iwasz/gp8-clock/README

Stopwatch project for moto-gymkhana.
In case you don't know what is moto-gymkhana : https://www.youtube.com/watch?v=KFEh59GVMnQ
