iwasz/gp8-clock/hw-design/receiver/gp8-clock.ods

10 | D1 | weight-scale-backlight | 1 | LED | 0 | with LCD | 0 | 0 |  | 0
11 | U2 | MSOP10 | 1 | MCP73833 | 0 |  | 0 | 0 |  | 0
12 | SW1 | pin_socket_2 | 1 | power | 0 |  | 0 | 0 |  | 0
16 | P1 | pin_socket_3 | 1 | CONN_01X03 | 0 |  | 0 | 0 |  | 0
18 | P6 | pin_socket_2 | 1 | CONN_01X02 | 0 |  | 0 | 0 |  | 0
19 | P8 | pin_socket_2 | 1 | OptionB | 0 |  | 0 | 0 |  | 0
20 | P9 | pin_socket_2 | 1 | OptionA | 0 |  | 0 | 0 |  | 0
21 | P12 | pin_socket_2 | 1 | OptionC | 0 |  | 0 | 0 |  | 0
23 | R9 | 0207%2f10 | 1 | current sense 1R | 0 |  | 0 | 0 |  | 0
 | bateria 300mah |  | 1 |  | 12 |  | 12 | 0 | 2 lub 3x AA | 0
19 | R9 | r_0603 | 1 | 560R | 0.02 |  | 0.02 | 0.02 |  | 0.02
20 | R13 | r_0603 | 1 | 1R | 0.02 |  | 0.02 | 0.02 |  | 0.02
21 | R22 | r_0603 | 1 | 220R | 0.02 |  | 0.02 | 0.02 |  | 0.02
23 | R28 | r_0603 | 1 | 3k3 | 0.02 |  | 0.02 | 0.02 |  | 0.02
7 | R4 | r_0603 | 1 | 3k3 | 0.02 |  | 0.02 | 0.02 |  | 0.02
8 | R5 | r_0603 | 1 | 33k | 0.02 |  | 0.02 | 0.02 |  | 0.02
10 | R8 | r_1210 | 1 | 2R | 0.02 |  | 0.02 | 0.02 |  | 0.02
11 | C1 | c_0603 | 1 | C | 0.03 |  | 0.03 | 0.03 |  | 0.03
12 | C2 | c_0603 | 1 | 1µF | 0.03 |  | 0.03 | 0.03 |  | 0.03
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
