iwasz/gp8-clock/doc/lcd-dmiensions.jpg

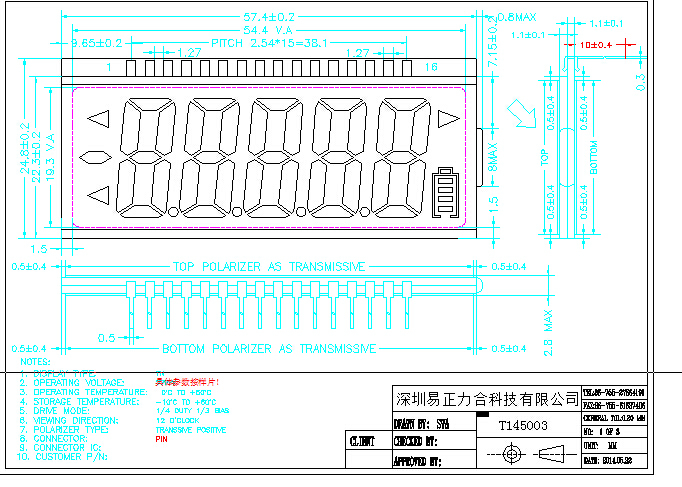
doc/lcd-dmiensions.jpg
