iwasz/gp8-clock/doc/lcd-pinout.jpg

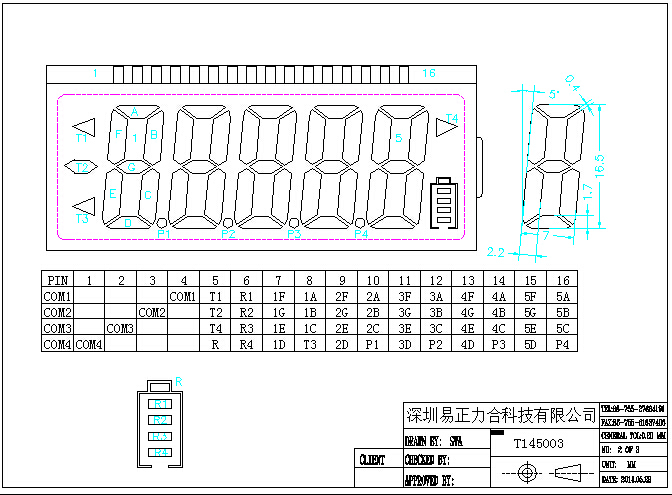
doc/lcd-pinout.jpg
