iwasz/gp8-clock/hw-design/receiver/board-outline/Screenshot from 2015-11-08 22:54:55.png

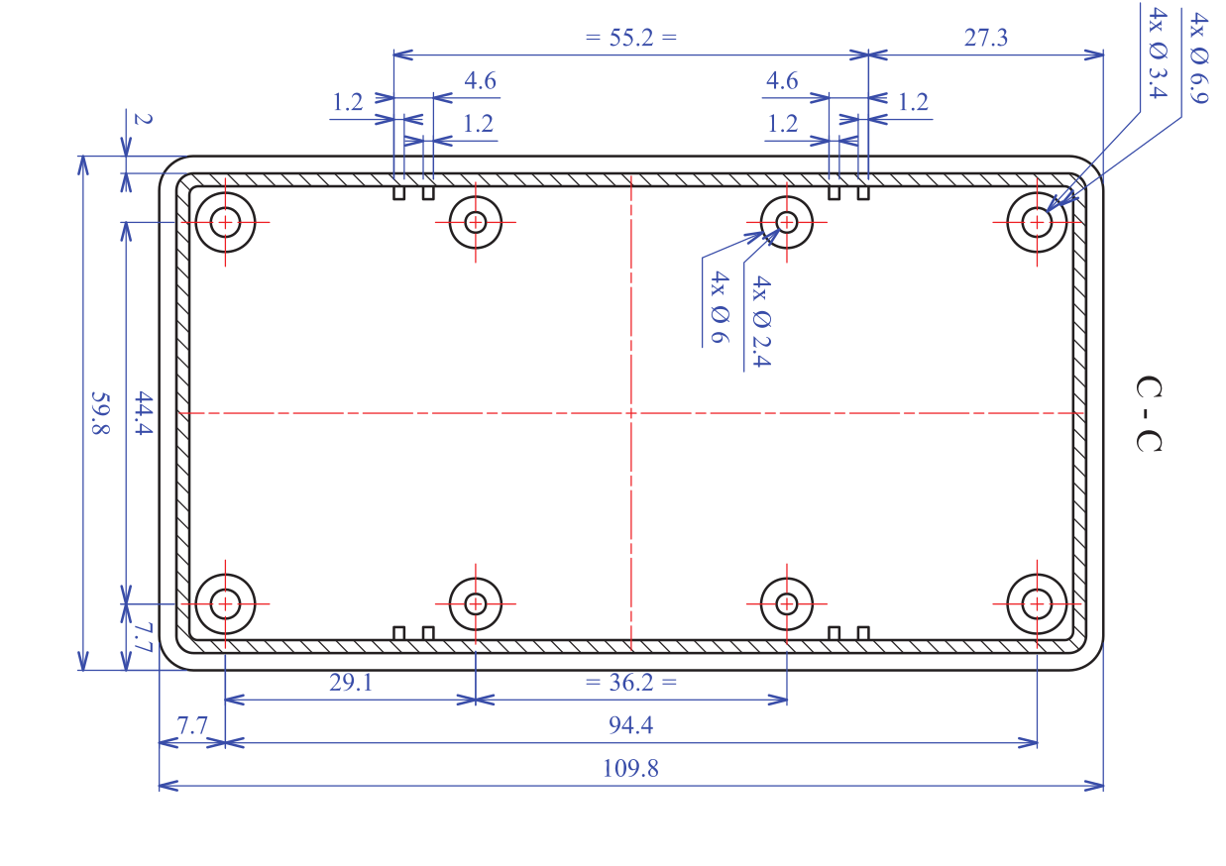
hw-design/receiver/board-outline/Screenshot from 2015-11-08 22:54:55.png
