iwasz/gp8-clock/hw-design/transmitter/board-outline/case.png

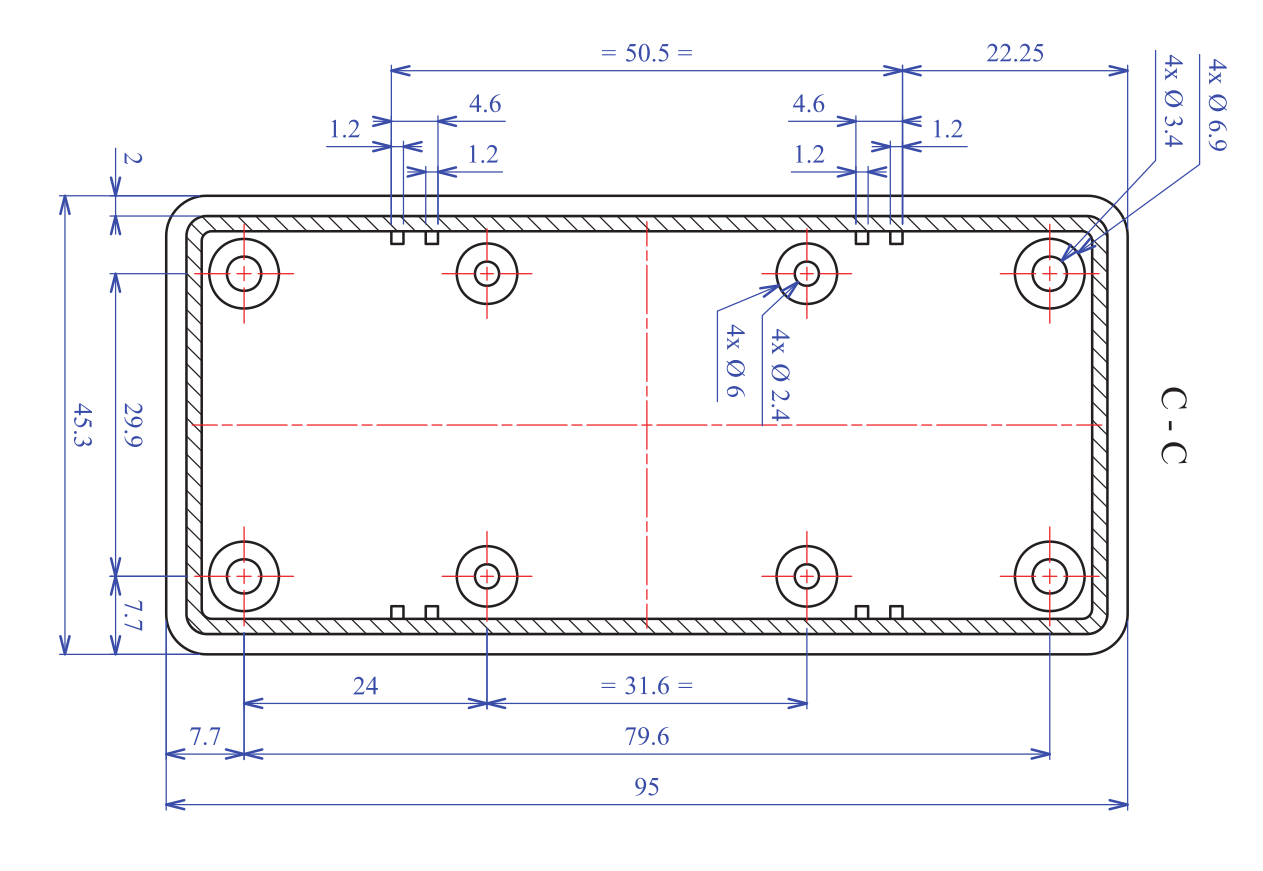
hw-design/transmitter/board-outline/case.png
