iwasz/gp8-clock/enclosure/transmitter.dxf

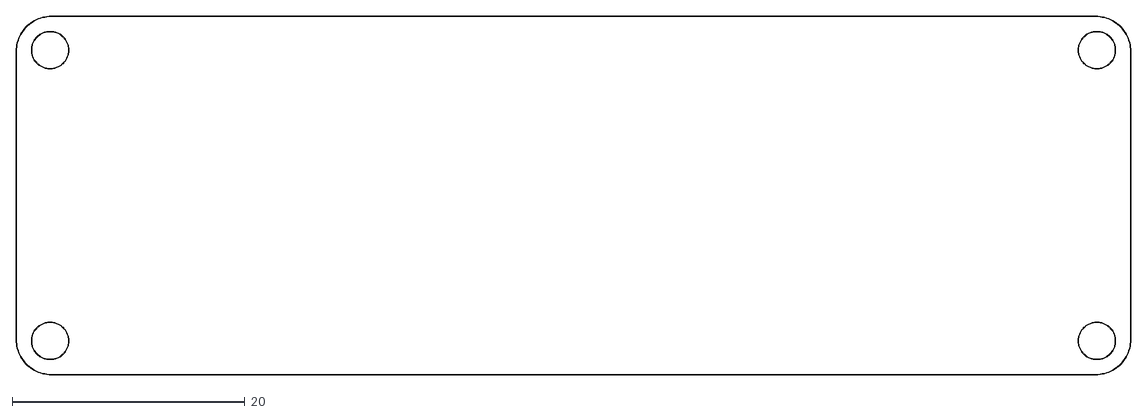
[picture p5: CAD file, 2019-07-06]
enclosure/transmitter.dxf
95.8 x 30.8
