iwasz/gp8-clock/hw-design/receiver/board-outline/drawing1.dxf

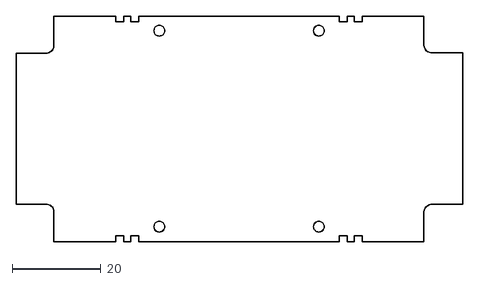
[picture p6: CAD file, 2015-11-10]
hw-design/receiver/board-outline/drawing1.dxf
100.7 x 50.9
