iwasz/gp8-clock/hw-design/transmitter/board-outline/drawing1.dxf

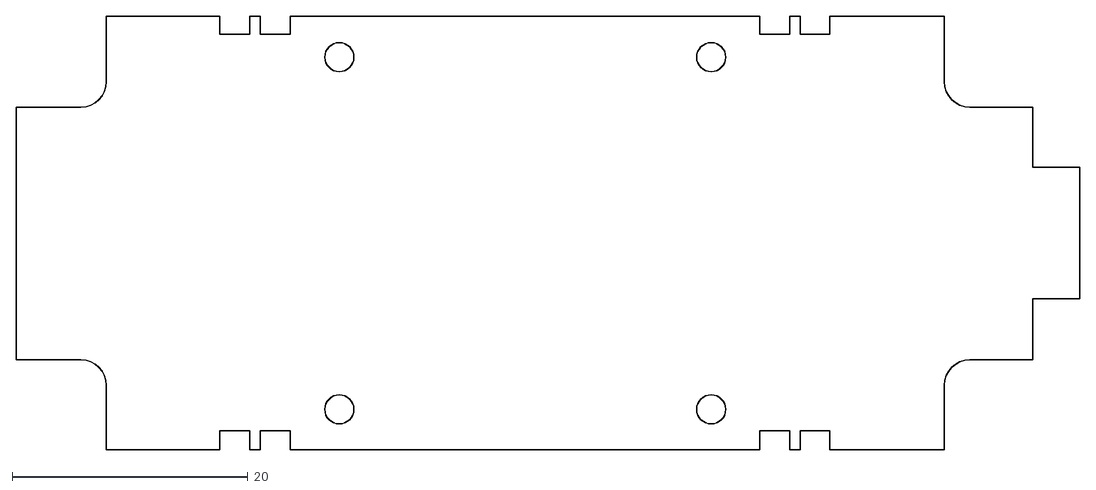
[picture p7: CAD file, 2015-11-11]
hw-design/transmitter/board-outline/drawing1.dxf
90.1 x 36.8
