iwasz/gp8-clock/hw-design/transmitter/transmitter.step

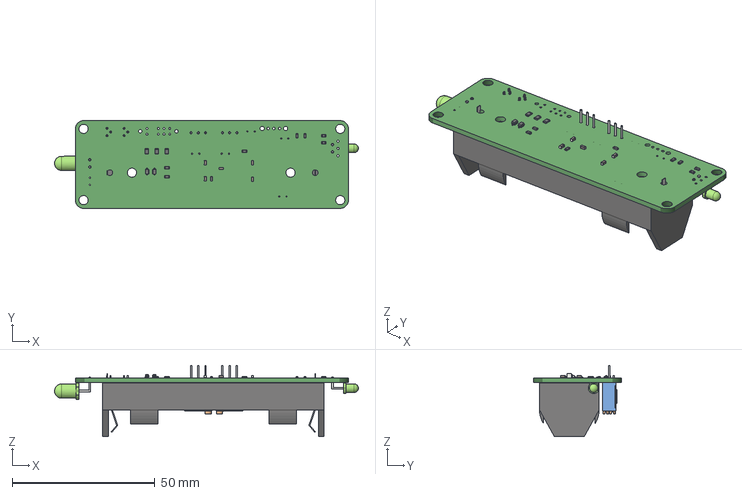
[picture p8: CAD file, 2019-07-06]
hw-design/transmitter/transmitter.step
106.6 x 30.8 x 25.0 mm
