iwasz/gp8-clock/enclosure/b.stl

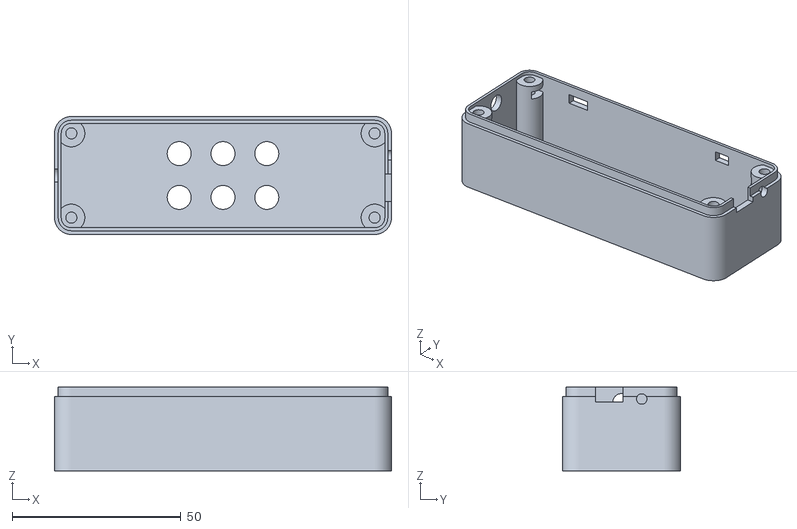
[picture p9: CAD file, 2019-07-06]
enclosure/b.stl
100.0 x 35.0 x 24.9
