iwasz/gp8-clock/enclosure/Power.dxf

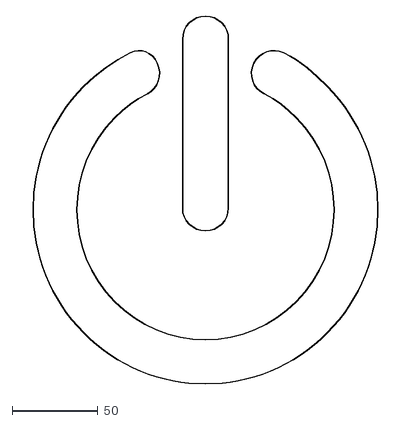
[picture p10: CAD file, 2019-07-06]
enclosure/Power.dxf
220.7 x 214.5
