iwasz/gp8-clock/enclosure/a.stl

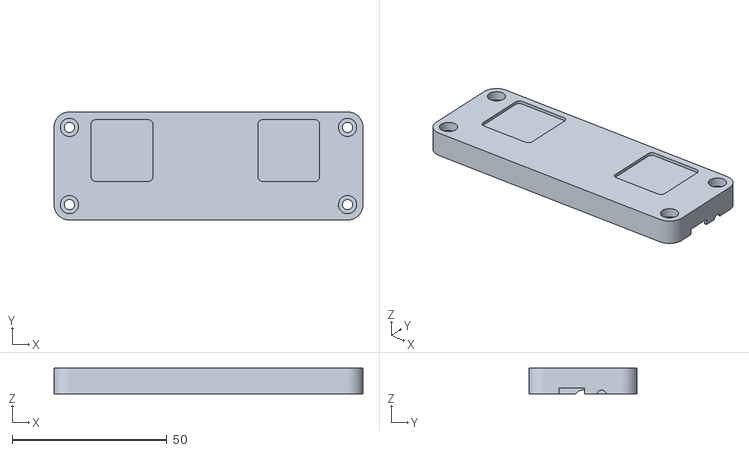
[picture p11: CAD file, 2019-07-06]
enclosure/a.stl
100.0 x 35.0 x 8.30
