iwasz/gp8-clock/enclosure/c.3mf

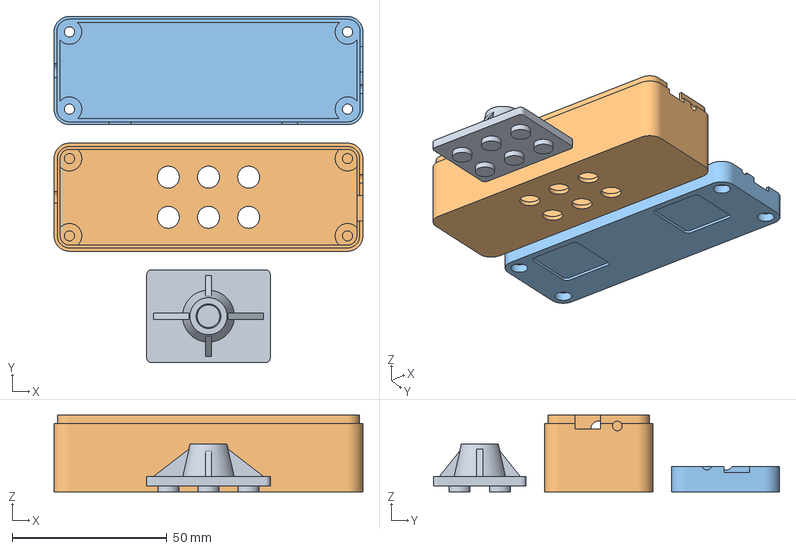
[picture p12: CAD file, 2019-07-06]
enclosure/c.3mf
100.0 x 112.0 x 24.9 mm
c.stl
b.stl
a.stl
