iwasz/gp8-clock/enclosure/icon-test.scad

linear_extrude(height = 5, center = true, convexity = 10)
import (file = "Power.dxf", layer = "plate");
