iwasz/gp8-clock/(list of files, cad)

Other CAD files:
enclosure/c.stl
