iwasz/gp8-clock/doc/EDS809-1.pdf

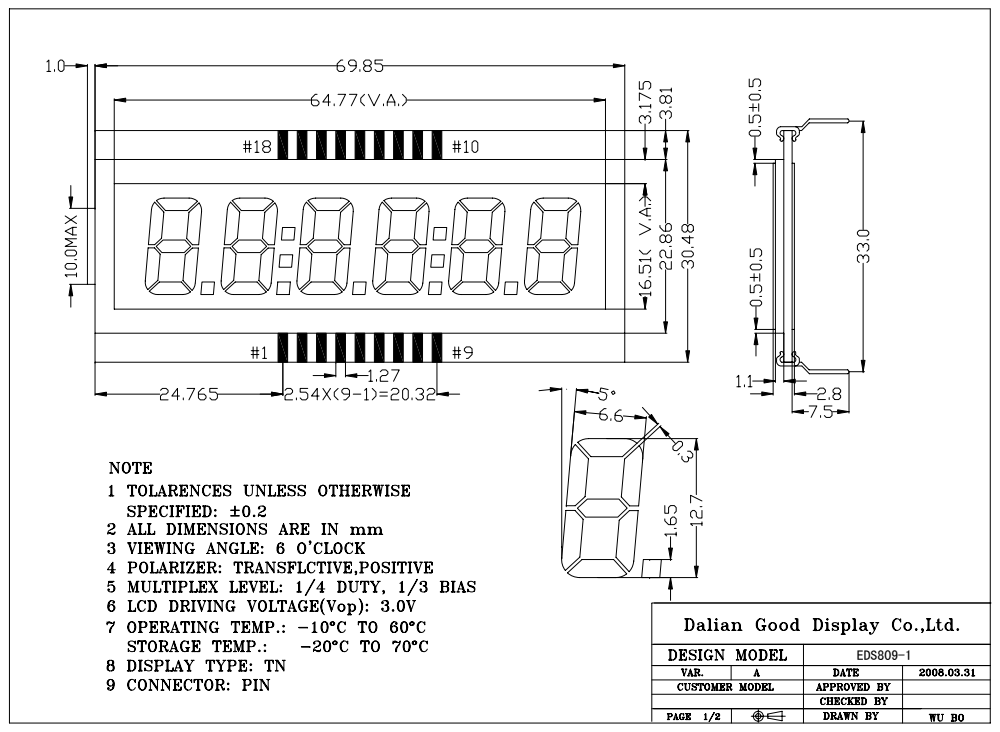
[picture p13: page 1]
EDS809-1

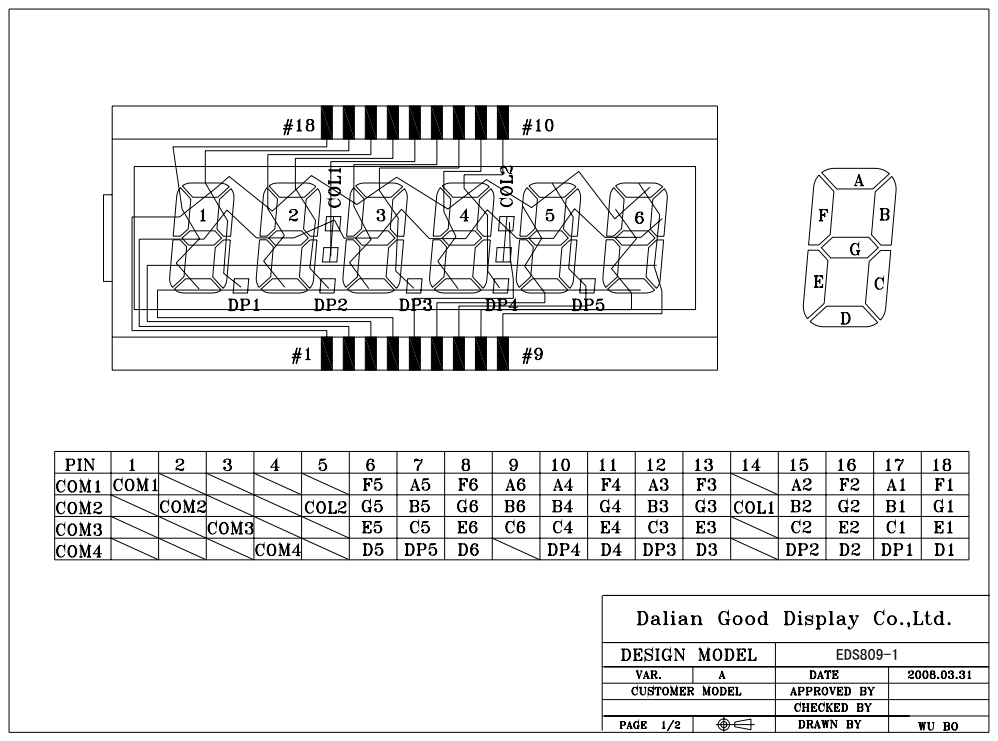
[picture p14: page 2]
EDS809-1
