iwasz/gp8-clock/doc/Z75.pdf

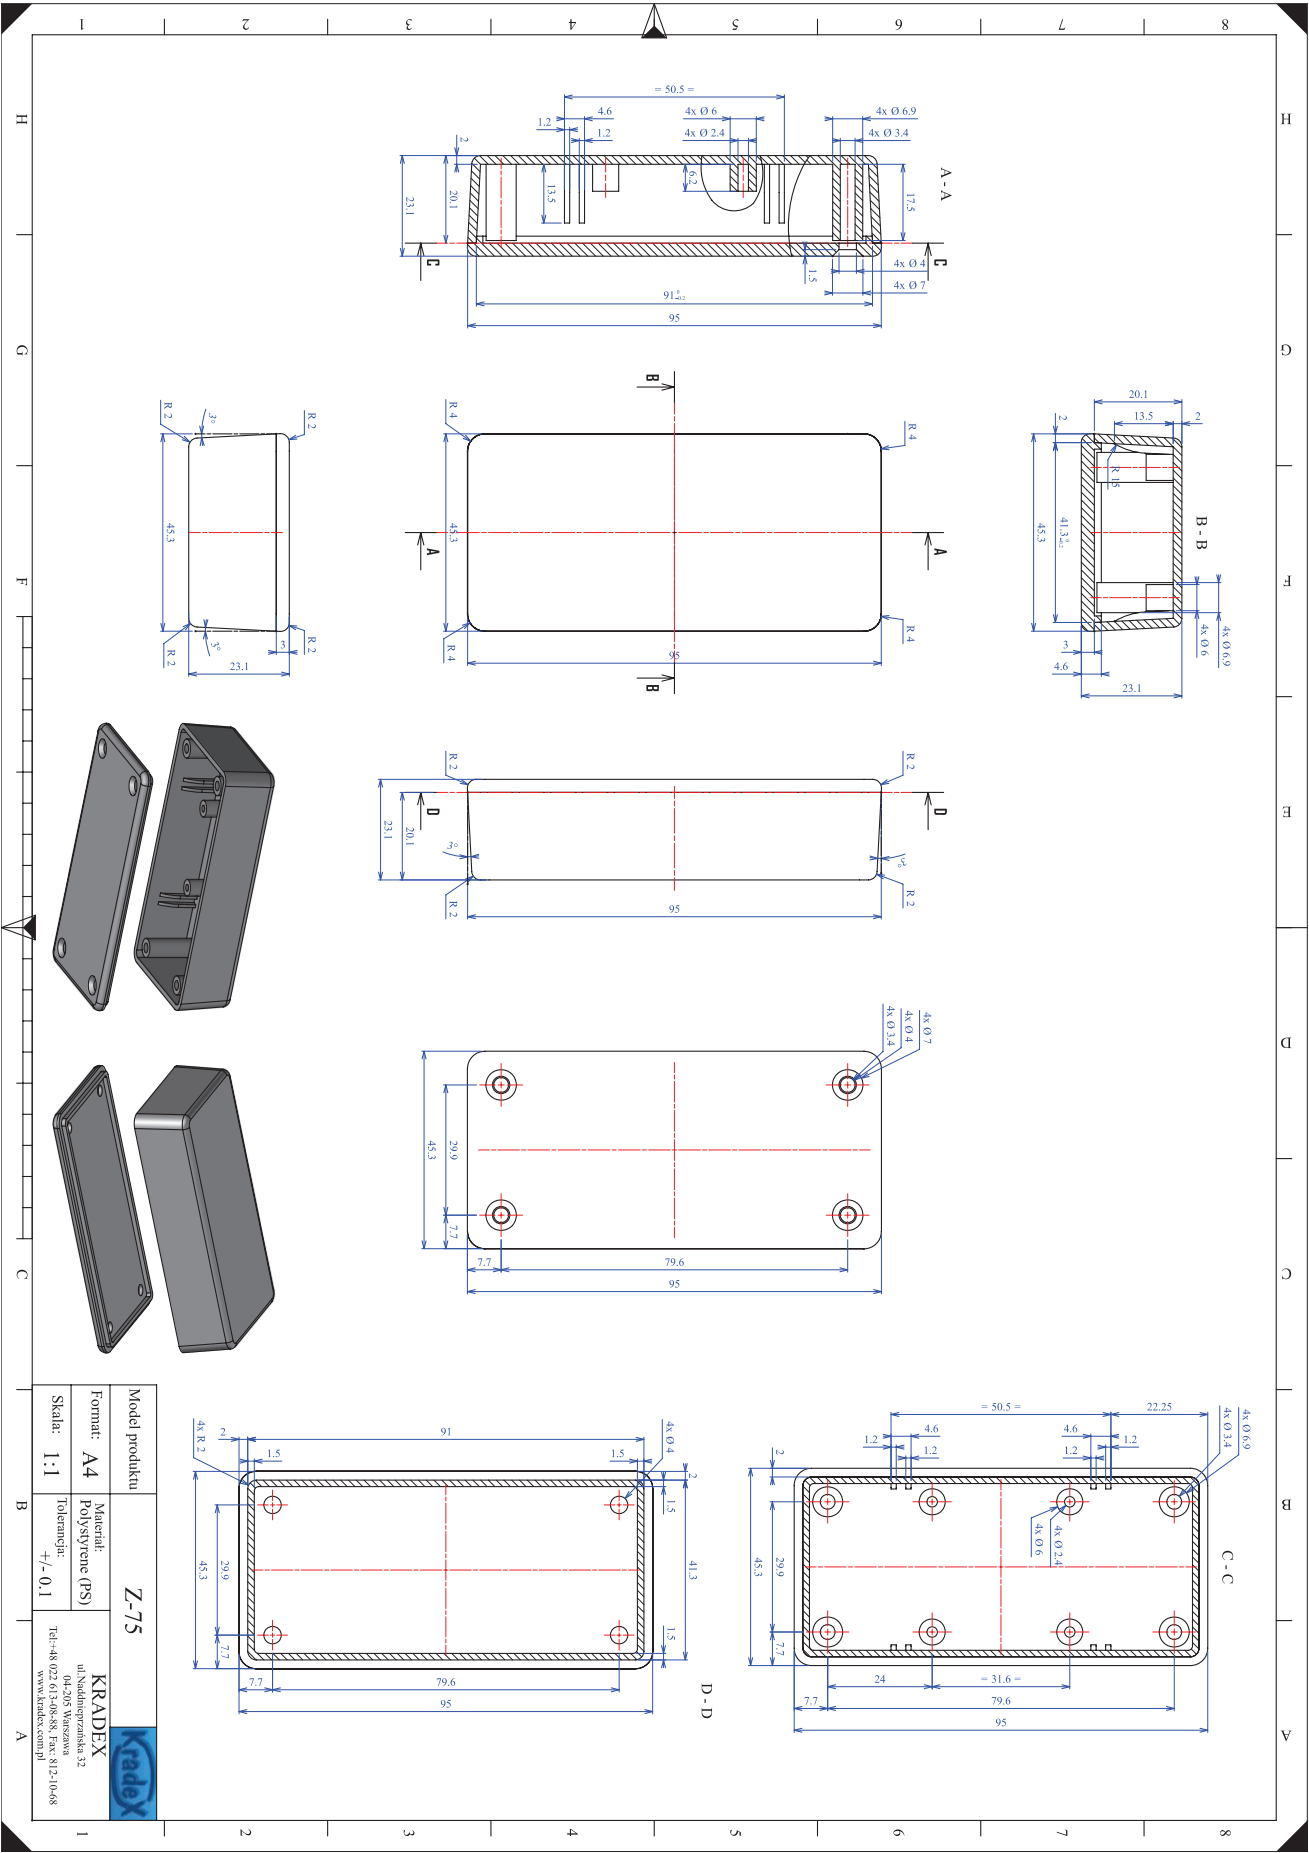
[picture p15: page 1]
