iwasz/gp8-clock/doc/Z76.pdf

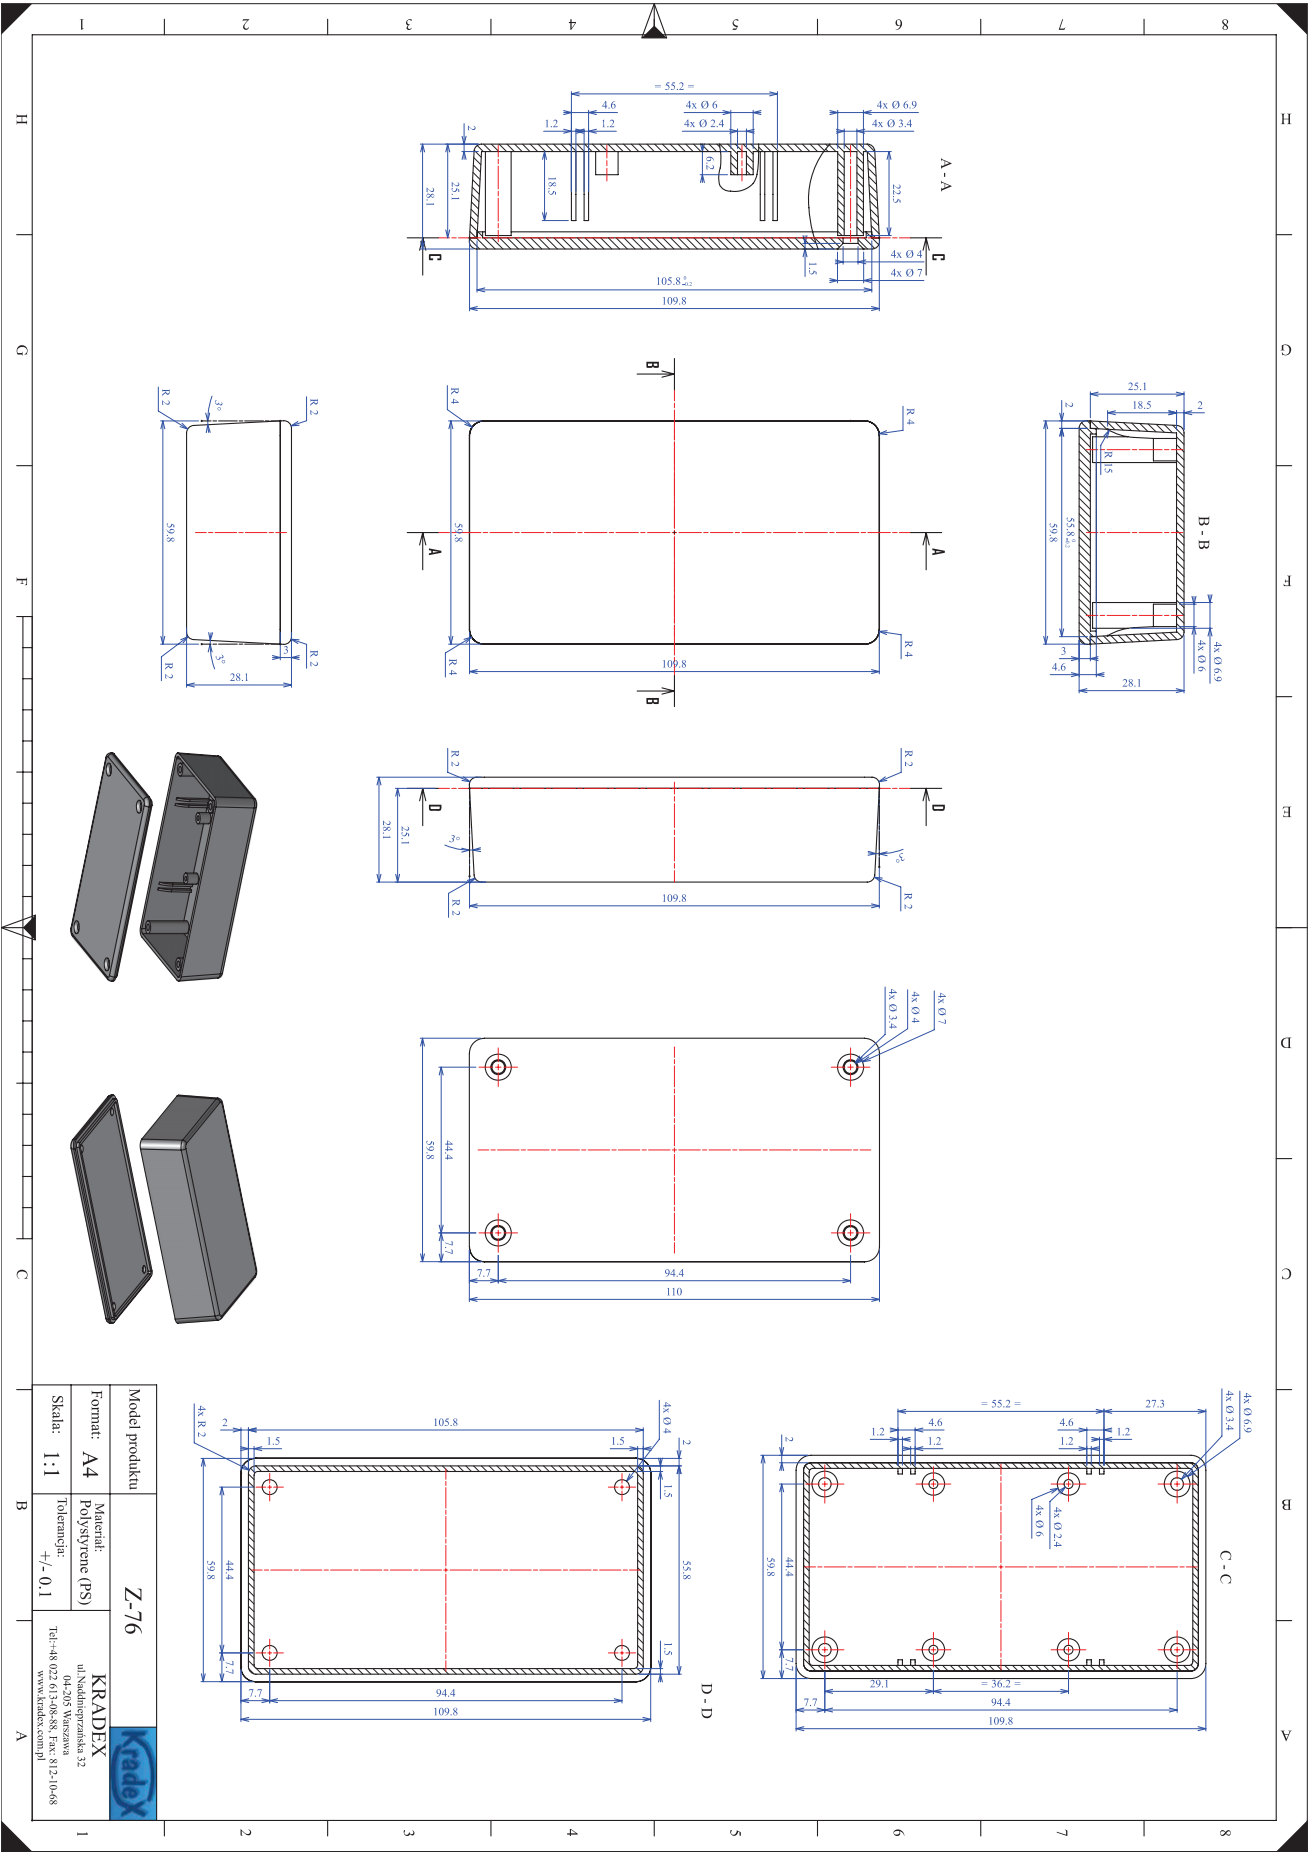
[picture p16: page 1]
