iwasz/gp8-clock/hw-design/transmitter/transmitter.kicad_pcb

## KiCad design hw-design/transmitter/transmitter.kicad_pcb (2019-07-06)

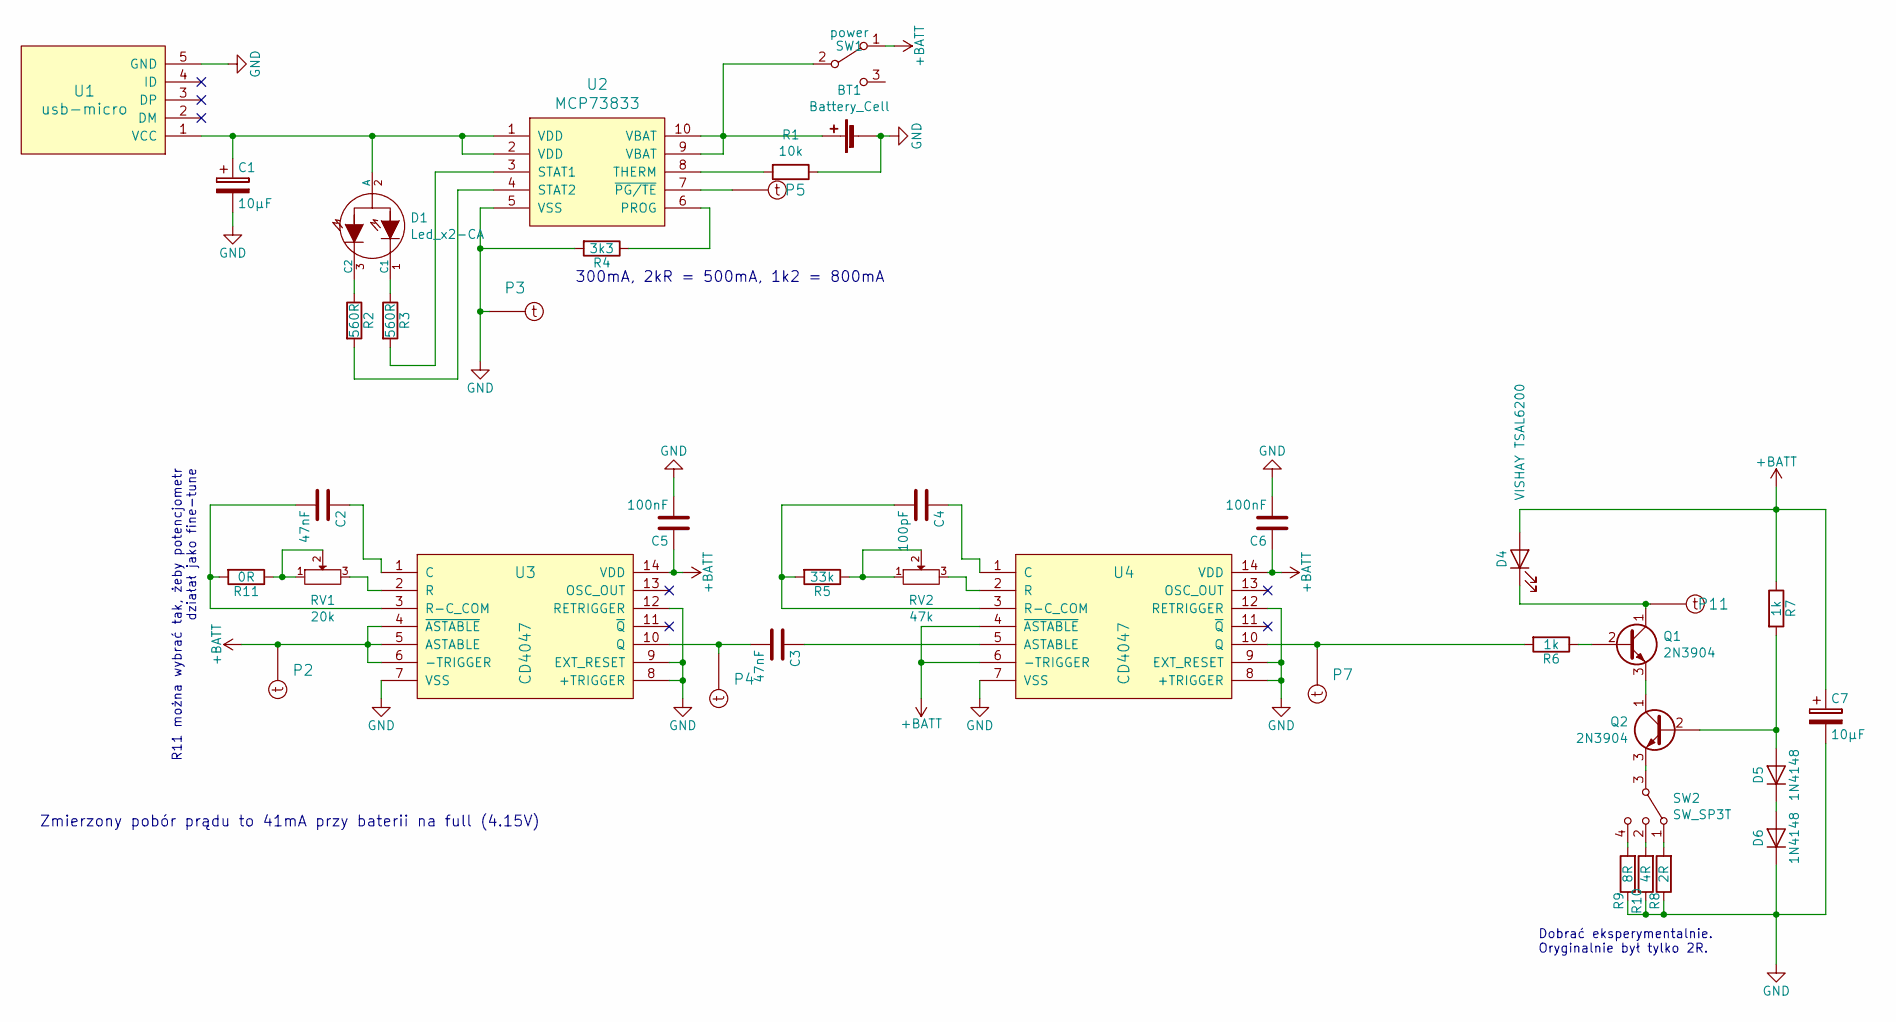
[picture p17: schematic transmitter.sch]

Parts:
BT1: Battery_Cell; BatteryHolder_MPD_BH-18650-PC2
C1, C7: 10µF; c_tant_B-pins21
C2, C3: 47nF; C_0603_1608Metric
C4: 100pF; C_0603_1608Metric
C5, C6: 100nF; C_0603_1608Metric
D1: Led_x2-CA; led_3mm-3pins
D4: VISHAY TSAL6200; LED_D5.0mm_Horizontal_O3.81mm_Z3.0mm
D5, D6: 1N4148; D_SOD-323
P2, P3, P4, P5, P7, P11: test-double; testpad-2p
Q1, Q2: 2N3904; TO-92
R1: 10k; R_0603_1608Metric
R2, R3: 560R; R_0603_1608Metric
R4: 3k3; R_0603_1608Metric
R5: 33k; R_0603_1608Metric
R6, R7: 1k; R_0603_1608Metric
R8: 2R; R_0805_2012Metric
R9: 8R; R_0805_2012Metric
R10: 4R; R_0805_2012Metric
R11: 0R; R_0603_1608Metric
RV1: 20k; Potentiometer_Bourns_3296W_Vertical
RV2: 47k; Potentiometer_Bourns_3296W_Vertical
SW1: power; MFP 201 NR
SW2: SW_SP3T; MFP-1323-R
U1: usb-micro; conn_usb_B_micro_smd-2-nohole
U2: MCP73833; MSOP-10_3x3mm_P0.5mm
U3, U4: CD4047; SOIC-14_3.9x8.7mm_P1.27mm

Connections:
+BATT: C5.1, C6.1, C7.1, D4.2 (A), P2.1, R7.1, SW1.1 (A), U3.4 (~ASTABLE), U3.5 (ASTABLE), U3.6 (-TRIGGER), U3.14 (VDD), U4.4 (~ASTABLE), U4.6 (-TRIGGER), U4.14 (VDD)
GND: BT1.2 (-), C1.2, C5.2, C6.2, C7.2, D6.1 (K), P3.1, R1.1, R4.2, R8.1, R9.1, R10.1, U1.5 (GND), U2.5 (VSS), U3.7 (VSS), U3.8 (+TRIGGER), U3.9 (EXT_RESET), U3.12 (RETRIGGER), U4.7 (VSS), U4.8 (+TRIGGER), U4.9 (EXT_RESET), U4.12 (RETRIGGER)
unnamed: BT1.1 (+), SW1.2 (B), U2.9 (VBAT), U2.10 (VBAT)
unnamed: C1.1, D1.2 (A), U1.1 (VCC), U2.1 (VDD), U2.2 (VDD)
unnamed: C2.1, U3.1 (C)
unnamed: C2.2, R11.2, U3.3 (R-C_COM)
unnamed: C3.1, U4.5 (ASTABLE)
unnamed: C3.2, P4.1, U3.10 (Q)
unnamed: C4.1, U4.1 (C)
unnamed: C4.2, R5.2, U4.3 (R-C_COM)
unnamed: D1.1 (C1), R3.1
unnamed: D1.3 (C2), R2.1
unnamed: D4.1 (K), P11.1, Q1.1 (C)
unnamed: D5.1 (K), D6.2 (A)
unnamed: D5.2 (A), Q2.2 (B), R7.2
unnamed: P5.1, U2.7 (~PG/TE)
unnamed: P7.1, R6.2, U4.10 (Q)
unnamed: Q1.2 (B), R6.1
unnamed: Q1.3 (E), Q2.1 (C)
unnamed: Q2.3 (E), SW2.3
unnamed: R1.2, U2.8 (THERM)
unnamed: R2.2, U2.4 (STAT2)
unnamed: R3.2, U2.3 (STAT1)
unnamed: R4.1, U2.6 (PROG)
unnamed: R5.1, RV2.1, RV2.2
unnamed: R8.2, SW2.1
unnamed: R9.2, SW2.4
unnamed: R10.2, SW2.2
unnamed: R11.1, RV1.1, RV1.2
unnamed: RV1.3, U3.2 (R)
unnamed: RV2.3, U4.2 (R)

Notes on the sheet:
300mA, 2kR = 500mA, 1k2 = 800mA
Zmierzony pobór prądu to 41mA przy baterii na full (4.15V)
Dobrać eksperymentalnie. Oryginalnie był tylko 2R.
R11 można wybrać tak, żeby potencjometr działał jako fine-tune

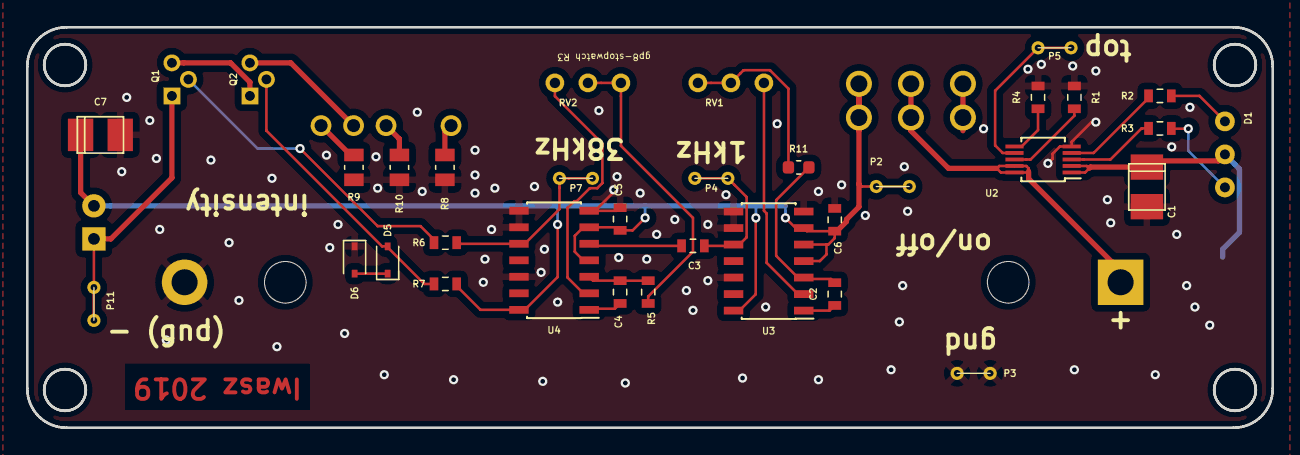
[picture p18: board transmitter.kicad_pcb from above]

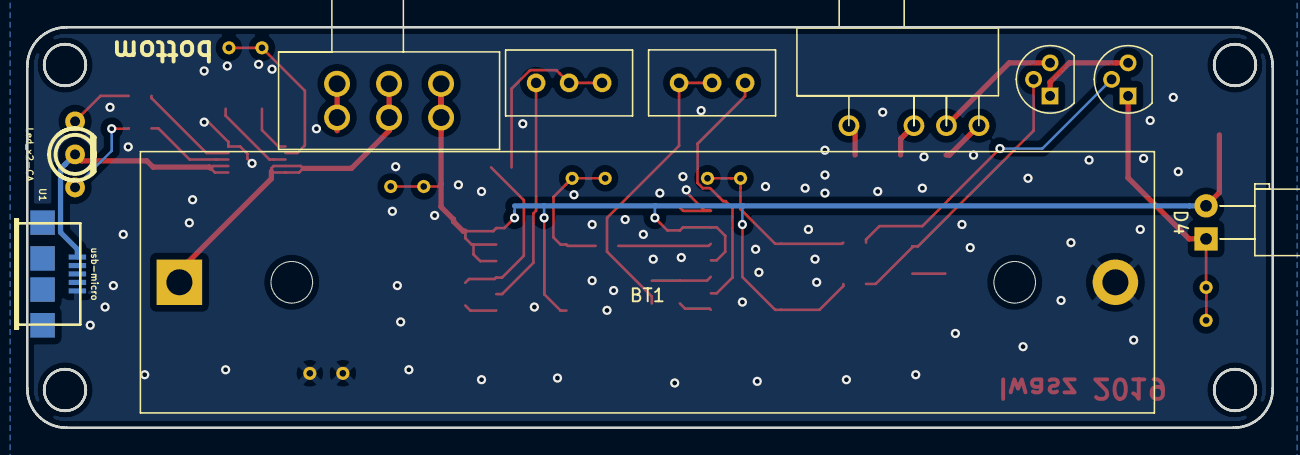
[picture p19: board transmitter.kicad_pcb from below]

Board: 2 copper layers, 95.8 x 30.8 mm, 39 parts (10 on the bottom side), 31 nets.
