iwasz/gp8-clock/hw-design/receiver/gp8-clock.kicad_pcb

## KiCad design hw-design/receiver/gp8-clock.kicad_pcb (2019-07-03)

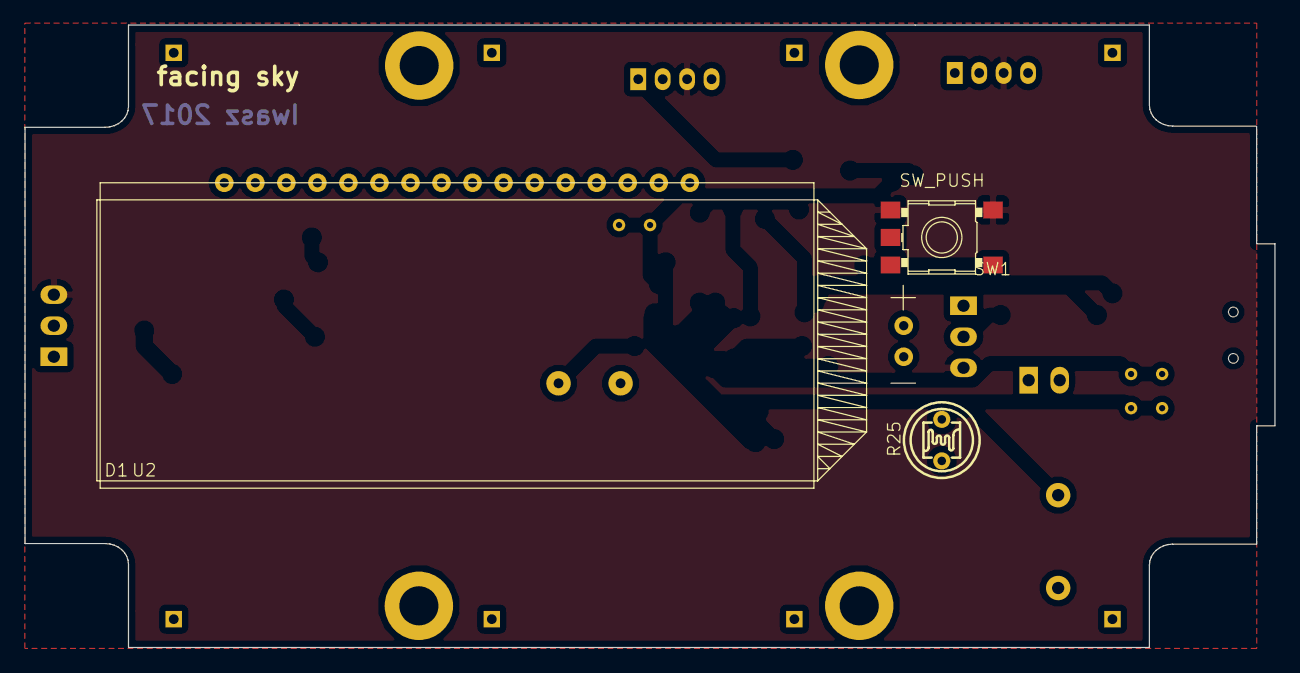
[picture p20: board gp8-clock.kicad_pcb from above]

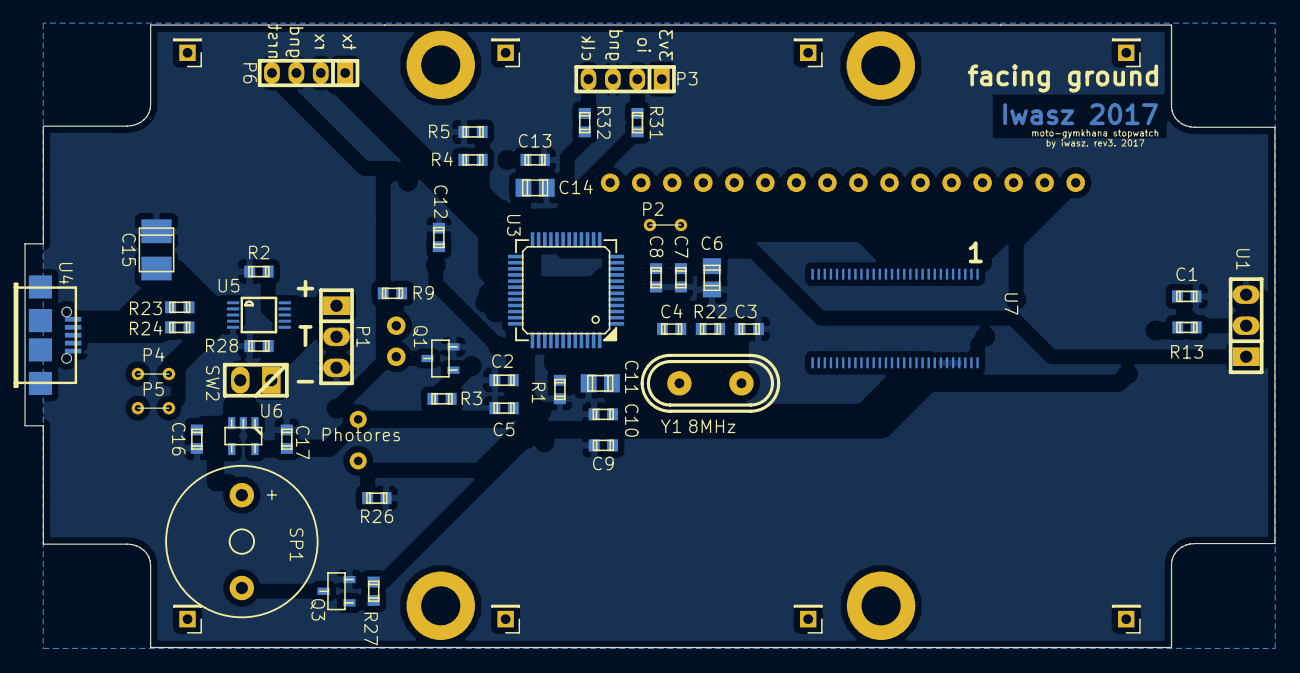
[picture p21: board gp8-clock.kicad_pcb from below]

Board: 2 copper layers, 102.3 x 50.9 mm, 65 parts (61 on the bottom side), 54 nets, no tracks yet.

Parts:
C1: C; c_0603
C2: 1µF; c_0603
C3, C4: ?10pF; c_0603
C5: 10nF; c_0603
C6, C11, C14: 4.7µF; c_0805
C7, C8, C9, C10, C12, C13: 100nF; c_0603
C15: 10µF; c_tant_B
C16, C17: 1µF, X5R, X7R, 25V; c_0603
D1: LED; weight-scale-backlight
J1, J10, J11, J12: CONN_01X01; MountingHole_3.2mm_M3_DIN965_Pad
J2, J3, J4, J5, J6, J7, J8, J9: CONN_01X01; Pin_Header_Straight_1x01_Pitch2.00mm
P1: CONN_01X03; pin_strip_3
P2, P4, P5: test-double; testpad-2p
P3, P6: CONN_01X04; pin_strip_2mm_4
Q1, Q3: BC847; sot23
R1, R2, R26: 10k; r_0603
R3, R27: 1k; r_0603
R4, R5: 5k6; r_0603
R9: 560R; r_0603
R13: 1R; r_0603
R22: 220R; r_0603
R23, R24, R31, R32: 22R; r_0603
R25: Photores; T0-46-A10XX
R28: 3k3; r_0603
SP1: BUZZER; Buzzer_12x9.5RM7.6
SW1: SW_PUSH; tact-switch-smd
SW2: power; pin_strip_2
U1: TSOP39538; pin_strip_3
U2: weight-scale-lcd
U3: STM32F072CB / STM32F042C6; lqfp48
U4: usb-micro; conn_usb_B_micro_smd-2
U5: MCP73833; MSOP10
U6: MIC5504; sot23-5
U7: PCF85176T; TSSOP56-6
Y1: 8MHz; crystal_hc-49s

Connections:
+3V3: C2.1, C5.1, C6.1, C7.1, C8.1, C9.1, C10.1, C11.1, C13.1, C14.1, C17.1, P3.1, R13.1, R25.1, U3.9, U3.24, U3.36, U3.48, U6.5, U7.48, U7.55
+5V: C15.1, U4.1, U5.1, U5.2
+BATT: C16.1, R4.2, R9.2, SP1.1, SW2.2, U6.1, U6.3
/Sheet56372EC5/complete: P5.1, U3.2, U5.4
/Sheet56372EC5/progress: P4.1, U3.46, U5.3
/backlight: R3.1, U3.11
/consoleRx: P6.2, U3.31
/consoleTx: P6.1, U3.30
/ir: U1.1, U3.19
/nrst: P2.1, P6.4, U3.7
/screen/scl: U3.42, U7.45
/screen/sda: U3.43, U7.44
/sense: R4.1, R5.2, U3.13
/sound: R27.1, U3.4
/swdclk: R32.2, U3.37
/swdio: R31.2, U3.34
GND: C1.2, C2.2, C3.2, C4.2, C5.2, C6.2, C7.2, C8.2, C9.2, C10.2, C11.2, C12.2, C13.2, C14.2, C15.2, C16.2, C17.2, P1.3, P3.3, P6.3, Q1.3, Q3.3, R1.2, R2.1, R5.1, R26.2, R28.2, SW1.2, U1.3, U3.8, U3.23, U3.35, U3.47, U4.5, U5.5, U6.2, U7.49, U7.50, U7.51, U7.52, U7.53, U7.54
unnamed: C1.1, R13.2, U1.2
unnamed: C3.1, U3.5, Y1.1
unnamed: C4.1, R22.2, Y1.2
unnamed: C12.1, SW1.1, U3.45
unnamed: D1.1, Q1.2
unnamed: D1.2, R9.1
unnamed: P1.1, SW2.1, U5.9, U5.10
unnamed: P1.2, R2.2, U5.8
unnamed: P3.2, R31.1
unnamed: P3.4, R32.1
unnamed: Q1.1, R3.2
unnamed: Q3.1, R27.2
unnamed: Q3.2, SP1.2
unnamed: R1.1, U3.44
unnamed: R22.1, U3.6
unnamed: R23.1, U4.2
unnamed: R23.2, U3.32
unnamed: R24.1, U4.3
unnamed: R24.2, U3.33
unnamed: R25.2, R26.1, U3.3
unnamed: R28.1, U5.6
unnamed: U2.1, U7.56
unnamed: U2.2, U7.2
unnamed: U2.3, U7.1
unnamed: U2.4, U7.3
unnamed: U2.5, U7.4
unnamed: U2.6, U7.5
unnamed: U2.7, U7.6
unnamed: U2.8, U7.7
unnamed: U2.9, U7.8
unnamed: U2.10, U7.9
unnamed: U2.11, U7.10
unnamed: U2.12, U7.11
unnamed: U2.13, U7.12
unnamed: U2.14, U7.13
unnamed: U2.15, U7.14
unnamed: U2.16, U7.15
