iwasz/gp8-clock/src/StopWatch.h

/****************************************************************************
 *                                                                          *
 *  Author : lukasz.iwaszkiewicz@gmail.com                                  *
 *  ~~~~~~~~                                                                *
 *  License : see COPYING file for details.                                 *
 *  ~~~~~~~~~                                                               *
 ****************************************************************************/

#ifndef STOPWATCH_H
#define STOPWATCH_H

#include <cstdint>
#include <stm32f0xx_hal.h>

extern "C" void TIM14_IRQHandler ();
class FastStateMachine;
struct IDisplay;

class StopWatch {
public:
        StopWatch ();
        virtual ~StopWatch () {}

        static StopWatch *singleton ()
        {
                static StopWatch st;
                return &st;
        }

        void init ();
        void reset () { time = 0; }
        void start () { running = true; }
        void stop () { running = false; }
        uint16_t getTime () const { return time; }

        void setDisplay (IDisplay *d) { this->display = d; }
        void setStateMachine (FastStateMachine *s) { this->stateMachine = s; }

        const uint16_t MAX_TIME = 100 * 60 * 10;

private:
        friend void TIM14_IRQHandler ();
        void onInterrupt ();

private:
        IDisplay *display;
        TIM_HandleTypeDef stopWatchTimHandle;
        bool running;
        uint16_t time = 0;
        FastStateMachine *stateMachine;
};

#endif // STOPWATCH_H
