iwasz/gp8-clock/(commit log)

2015-09-01 Proponowane ustawienia timera
2015-09-06 Works on the target device
2015-09-07 Works on the target configuration. First tests on attery power. Looks promising, 5m (15ft) range. Both draws 50mA
2015-11-06 hw design kicad
    [bluetooth.sch, gp8-clock.kicad_pcb, gp8-clock.sch, power.sch]
2015-11-10 Powiększona płytka
    [gp8-clock.kicad_pcb]
2015-11-10 Documentation, directory split, minors
    [bluetooth.sch, drawing1.dxf, gp8-clock.kicad_pcb, gp8-clock.sch, power.sch]
2015-11-11 Skończona rewizja r1, wysłane do satlanfd
    [drawing1.dxf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]
2016-01-03 Revision 2
    [bluetooth.sch, gp8-clock.kicad_pcb, gp8-clock.sch, power.sch, transmitter.kicad_pcb, transmitter.sch]
2016-01-07 Rewizja 2
    [gp8-clock-B.Cu.gbr, gp8-clock-B.Mask.gbr, gp8-clock-B.SilkS.gbr, gp8-clock-Edge.Cuts.gbr, gp8-clock-F.Cu.gbr, gp8-clock-F.Mask.gbr, gp8-clock-F.SilkS.gbr, gp8-clock-NPTH.drl]
2016-01-27 Funkcjonaloność tego zegara na LEDac jest w tym momencie powtórzona na LCDku
    [gp8-clock.kicad_pcb, gp8-clock.sch, transmitter.kicad_pcb, transmitter.sch]
2016-09-14 Testy z tym fajnym chipem od LCD driverem
2017-03-06 HW changes, removed BLE, and changed chanrging and ldo circuits
    [gp8-clock.sch, power.sch, transmitter.sch]
2017-03-06 2017 improvements
    [gp8-clock.kicad_pcb, gp8-clock.sch, power.sch, screen.sch]
2017-05-15 New hw&fw
    [gp8-clock.kicad_pcb, gp8-clock.sch, power.sch, screen.sch]
2017-05-15 Gerbers added
    [gp8-clock-B.Cu.gbr, gp8-clock-B.Mask.gbr, gp8-clock-B.SilkS.gbr, gp8-clock-Edge.Cuts.gbr, gp8-clock-F.Cu.gbr, gp8-clock-F.Mask.gbr, gp8-clock-F.SilkS.gbr, gp8-clock-NPTH.drl]
2017-05-16 Timer runs, display is refreshed, stopwatch works, but cannot be stopped
2017-05-16 Pre refactoring functionality restored
    [gp8-clock.sch]
2017-05-17 Debug, ADC
2017-05-23 Backlight and battery monotoring. Faulty start/stop mehcanism
    [gp8-clock.sch]
2017-05-24 I finally managed to hack ADC that it works with 2 channels in pollingmode
2017-05-24 ADC works, battery and ambient light are measured correctly
    [main.cc]
2017-09-07 USB work in progress. Enumerates OK
    [gp8-clock.ods, gp8-clock.sch, transmitter.csv, transmitter.sch]
2017-09-07 USB work in progress. Prints "." dots in serial console
2017-09-08 Fixed USB connectivity. Memory allocation functions were undefined, so silently no allocation was performed in one spot in the code.
    [gp8-clock.ods]
2017-09-08 Results are reported via USB, but there are some bugs
    [Debug.cc, FastStateMachine.cc, History.cc, main.cc]
2017-09-08 Time printouts now padded with zeroes
2018-02-14 Somoe old fixes
    [transmitter.kicad_pcb, transmitter.sch]
2019-07-03 Many changes
    [gp8-clock-2018-02-15-12-23-03.sch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]
2019-07-06 New version of the transmitter and its enclosure is done
    [Power.dxf, a.stl, b.stl, c.3mf, c.stl, icon-test.scad, transmitter-kradex.kicad_pcb, transmitter.dxf]
